mrzign/ESPbat/resources/schematic_espdslc_v1.pdf

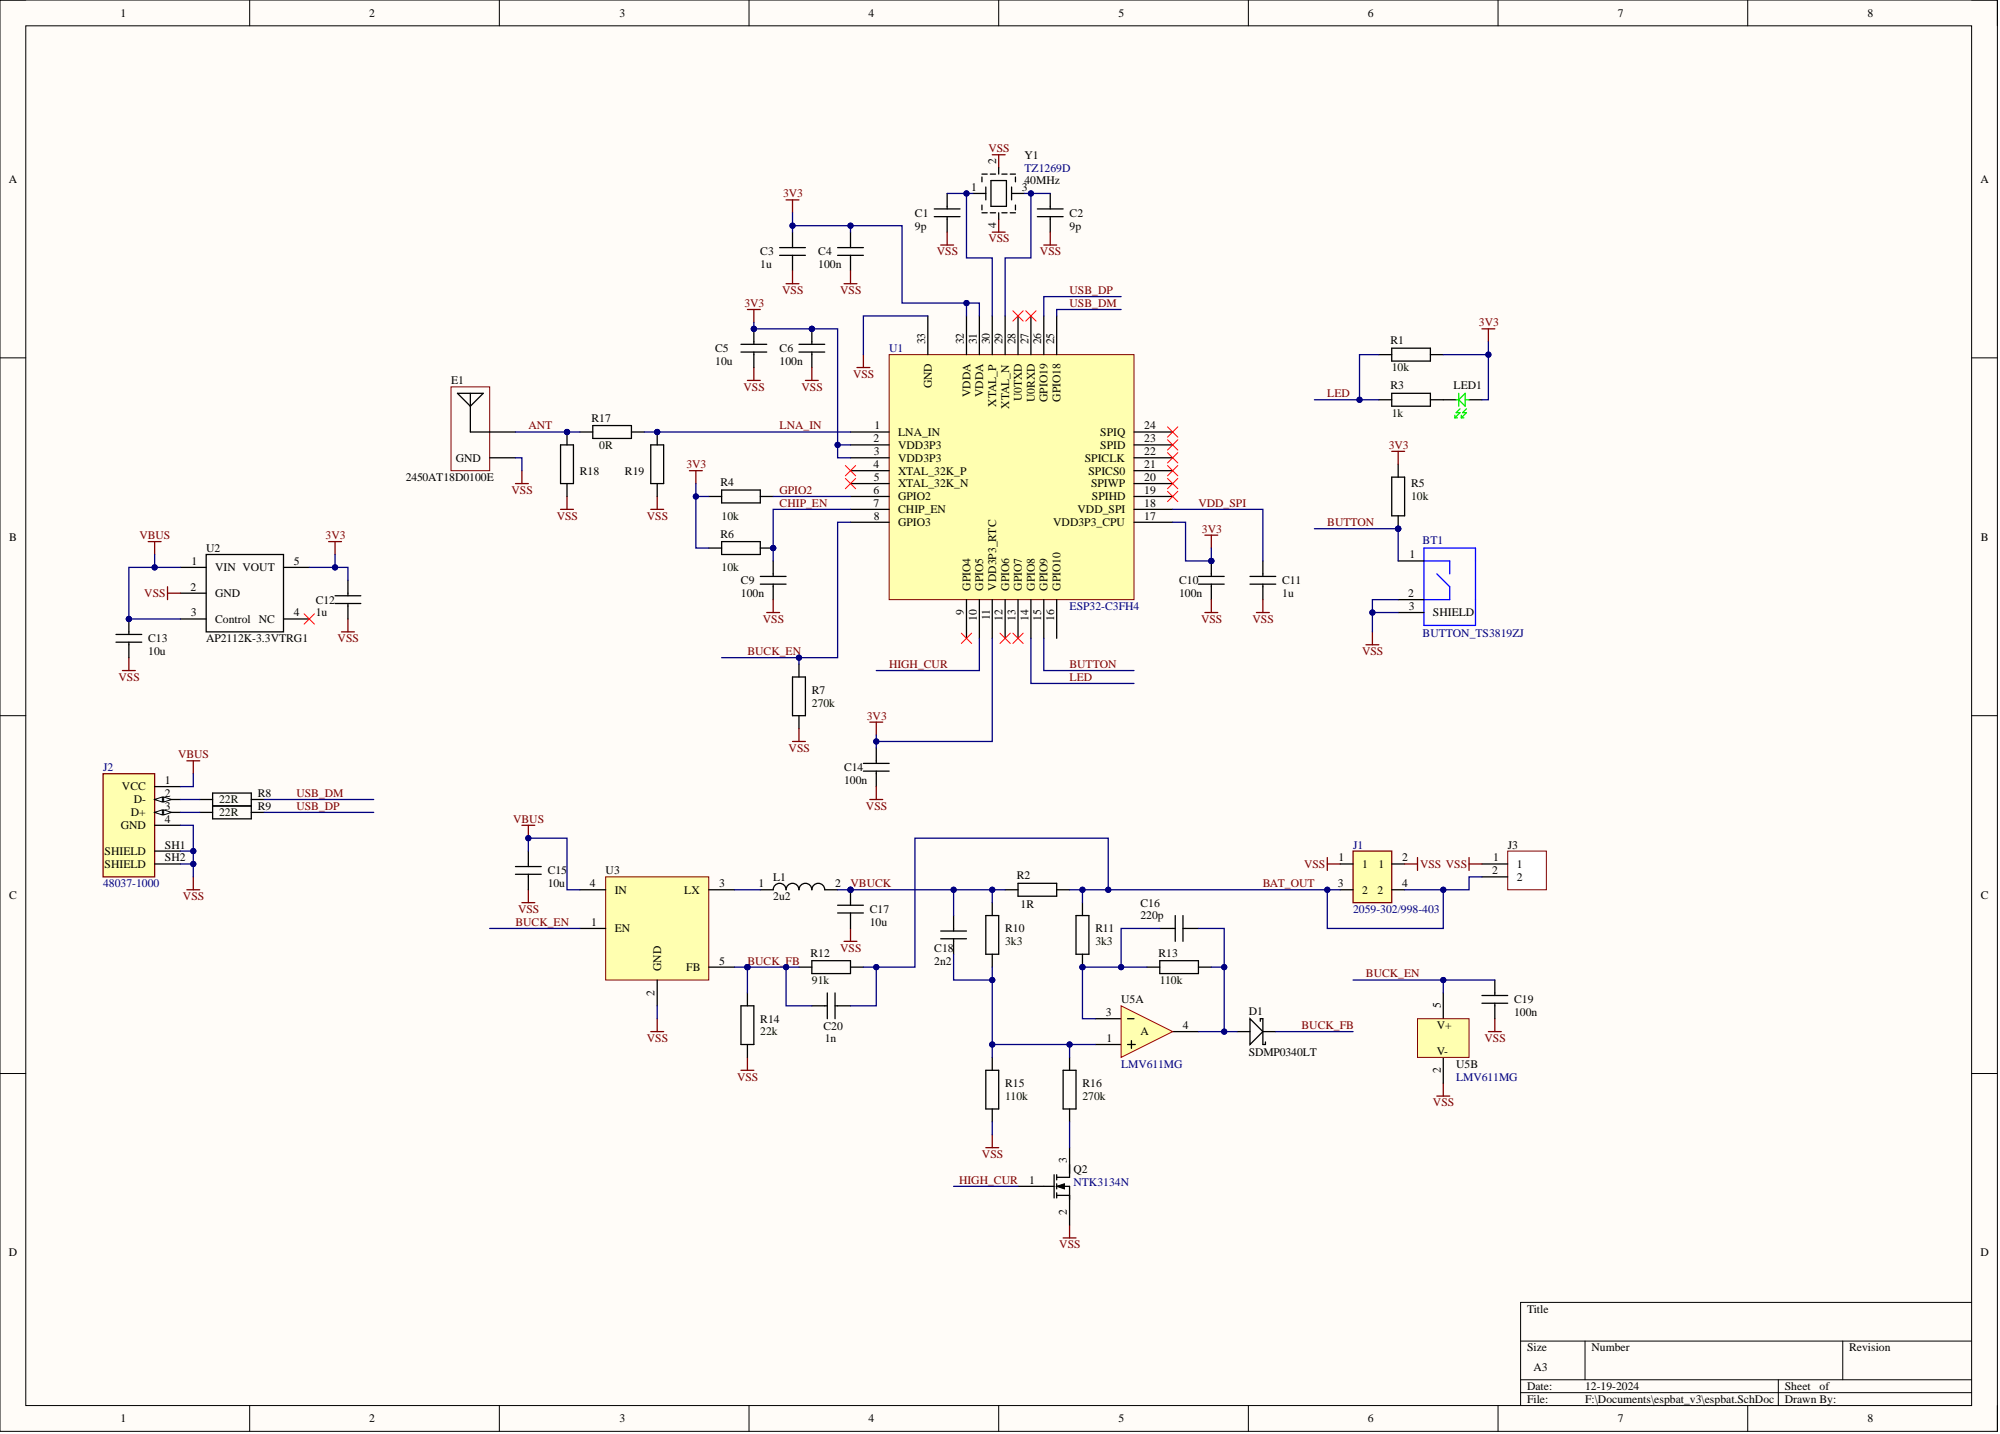
[picture p2: page 1]

GPIO10 16 VDD3P3_CPU 17 VDD_SPI 18 SPIHD 19 SPIWP 20 SPICS0 21 SPICLK 22 SPID 23 SPIQ 24

CHIP_EN 7
GPIO3 8

GND 2

SHIELD 3
